LiamMcDermott34/Muon-Detector/V2_Dual_Gieger_Counter/Photos/IMG_7273.webp

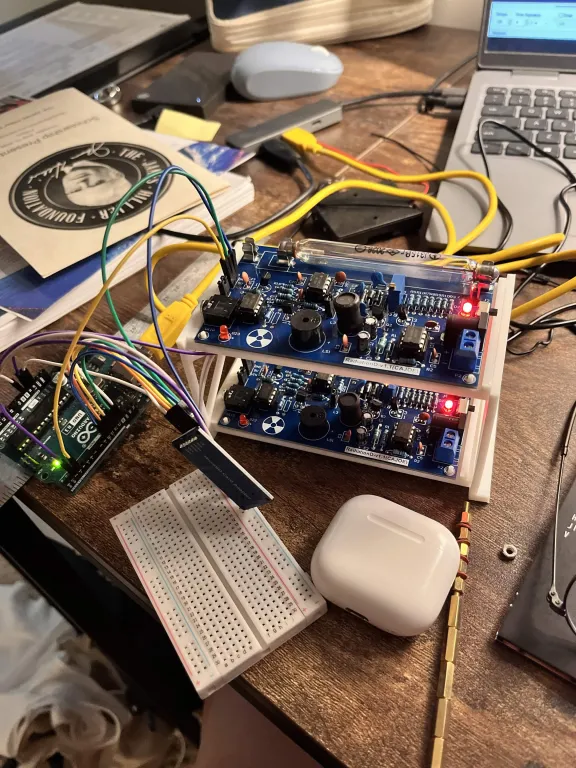
V2_Dual_Gieger_Counter/Photos/IMG_7273.webp
