LiamMcDermott34/Muon-Detector/V4_Moun_Data_Collector/Photos/IMG_7325.webp

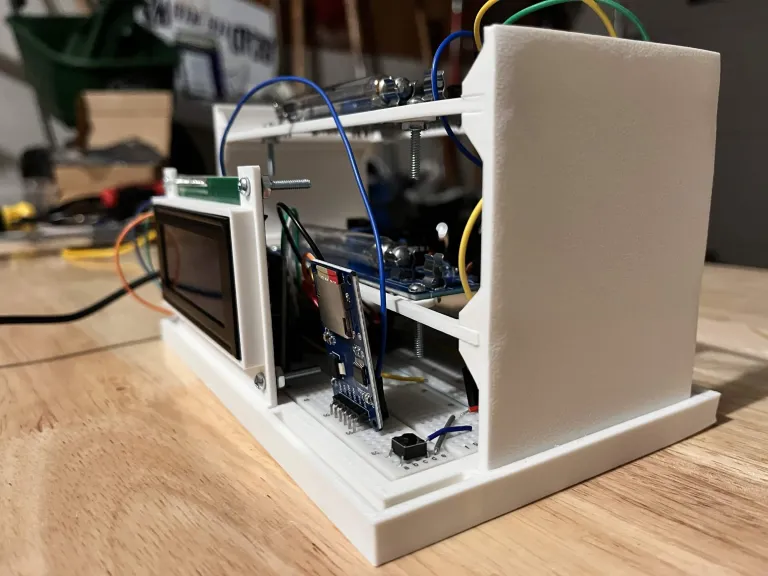
V4_Moun_Data_Collector/Photos/IMG_7325.webp
