LiamMcDermott34/Muon-Detector/V2_Dual_Gieger_Counter/Hardware/Fantastic Habbi-Jaban (5).3mf

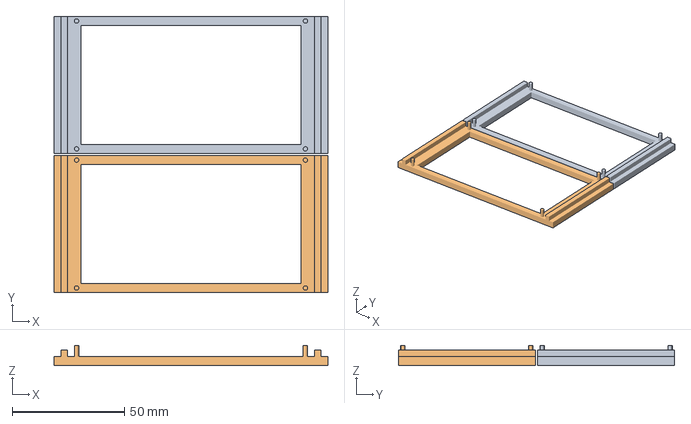
[picture p13: CAD file, 2026-07-22]
V2_Dual_Gieger_Counter/Hardware/Fantastic Habbi-Jaban (5).3mf
122.0 x 123.0 x 9.00 mm
Fantastic Habbi-Jaban (5).stl_A x 2
