LiamMcDermott34/Muon-Detector/V3_Moun_Density_Test/Hardware/Fantastic Habbi-Jaban (9).stl

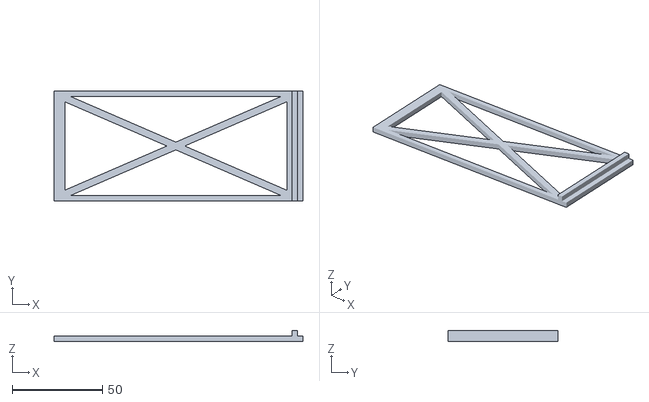
[picture p14: CAD file, 2026-07-22]
V3_Moun_Density_Test/Hardware/Fantastic Habbi-Jaban (9).stl
138.0 x 61.0 x 6.00
