LiamMcDermott34/Muon-Detector/V3_Moun_Density_Test/Hardware/Fantastic Habbi-Jaban (6).stl

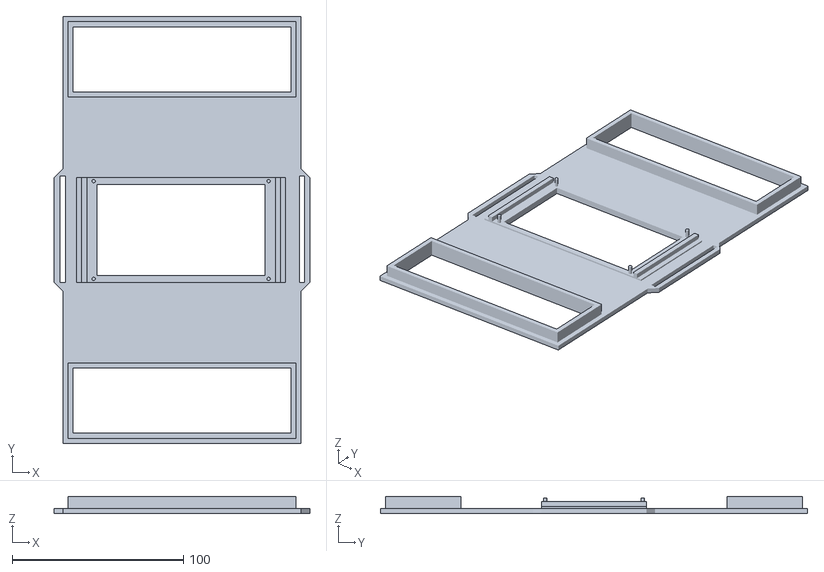
[picture p15: CAD file, 2026-07-22]
V3_Moun_Density_Test/Hardware/Fantastic Habbi-Jaban (6).stl
149.0 x 249.0 x 10.0
