LiamMcDermott34/Muon-Detector/V3_Moun_Density_Test/Hardware/Fantastic Habbi-Jaban (7).stl

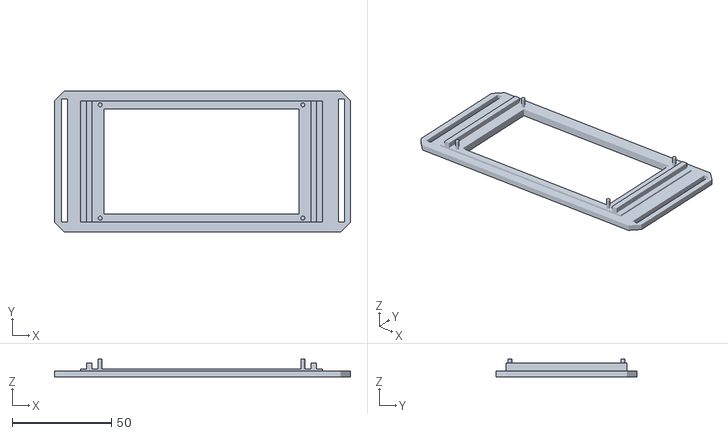
[picture p16: CAD file, 2026-07-22]
V3_Moun_Density_Test/Hardware/Fantastic Habbi-Jaban (7).stl
149.0 x 71.0 x 9.00
