LiamMcDermott34/Muon-Detector/(list of files, cad)

Other CAD files:
V2_Dual_Gieger_Counter/Hardware/Fantastic Habbi-Jaban (5).stl
