LiamMcDermott34/Muon-Detector/V3_Moun_Density_Test/DATA/DATA02.CSV

Time(ms) | D1_Counts | D2_Counts | Coincidences
60001 | 24 | 16 | 0
120001 | 45 | 36 | 0
180001 | 60 | 55 | 0
240001 | 81 | 74 | 0
300001 | 94 | 100 | 0
360001 | 112 | 123 | 0
420001 | 128 | 137 | 0
480001 | 147 | 161 | 0
540001 | 166 | 187 | 0
600001 | 183 | 206 | 0
660001 | 200 | 233 | 0
720001 | 221 | 261 | 0
780001 | 244 | 280 | 0
840001 | 267 | 301 | 0
900001 | 289 | 323 | 0
960001 | 310 | 348 | 1
1020001 | 325 | 366 | 1
1080001 | 346 | 383 | 2
1140001 | 357 | 406 | 2
1200001 | 376 | 420 | 2
1260001 | 393 | 432 | 2
1320001 | 417 | 448 | 2
1380001 | 438 | 470 | 2
1440001 | 460 | 484 | 2
1500001 | 476 | 505 | 2
1560001 | 494 | 528 | 2
1620001 | 513 | 550 | 2
1680001 | 536 | 575 | 3
1740001 | 542 | 590 | 3
1800001 | 562 | 615 | 3
1860001 | 573 | 639 | 3
1920001 | 593 | 652 | 3
1980001 | 610 | 676 | 3
2040001 | 629 | 692 | 3
2100001 | 651 | 709 | 3
2160001 | 670 | 738 | 3
2220001 | 690 | 757 | 3
2280001 | 710 | 782 | 3
2340001 | 727 | 803 | 3
2400001 | 743 | 815 | 3
2460001 | 764 | 841 | 4
2520001 | 783 | 865 | 4
2580001 | 805 | 890 | 4
2640001 | 821 | 912 | 4
2700001 | 844 | 930 | 4
2760001 | 862 | 943 | 4
2820001 | 887 | 950 | 4
2880001 | 903 | 973 | 5
2940001 | 915 | 986 | 6
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
