LiamMcDermott34/Muon-Detector/V3_Moun_Density_Test/DATA/DATA03.CSV

Time(ms) | D1_Counts | D2_Counts | Coincidences
60000 | 15 | 11 | 0
120000 | 27 | 31 | 0
180000 | 45 | 47 | 0
240000 | 58 | 63 | 0
300000 | 75 | 85 | 0
360000 | 97 | 104 | 0
420000 | 120 | 128 | 0
480000 | 134 | 146 | 0
540000 | 150 | 169 | 0
600000 | 165 | 184 | 0
660000 | 183 | 203 | 0
720000 | 196 | 220 | 0
780000 | 210 | 238 | 0
840000 | 220 | 256 | 0
900000 | 231 | 273 | 0
960000 | 243 | 291 | 0
1020000 | 255 | 312 | 0
1080000 | 270 | 328 | 0
1140000 | 291 | 347 | 0
1200000 | 304 | 359 | 0
1260000 | 321 | 380 | 0
1320000 | 334 | 398 | 0
1380000 | 350 | 413 | 0
1440000 | 371 | 437 | 0
1500000 | 382 | 463 | 0
1560000 | 394 | 487 | 0
1620000 | 411 | 501 | 0
1680000 | 422 | 521 | 0
1740000 | 439 | 542 | 0
1800000 | 456 | 558 | 0
1860000 | 471 | 572 | 0
1920000 | 490 | 587 | 1
1980000 | 505 | 599 | 1
2040000 | 518 | 613 | 1
2100000 | 537 | 627 | 1
2160000 | 544 | 647 | 1
2220000 | 561 | 668 | 1
2280000 | 571 | 686 | 1
2340000 | 582 | 699 | 1
2400000 | 601 | 718 | 1
2460000 | 618 | 736 | 1
2520000 | 631 | 753 | 1
2580000 | 645 | 778 | 1
2640000 | 670 | 792 | 1
2700000 | 688 | 810 | 1
2760000 | 708 | 825 | 1
2820000 | 716 | 848 | 1
2880000 | 727 | 859 | 1
2940000 | 741 | 883 | 1
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
