LiamMcDermott34/Muon-Detector/V3_Moun_Density_Test/Photos/IMG_7288.webp

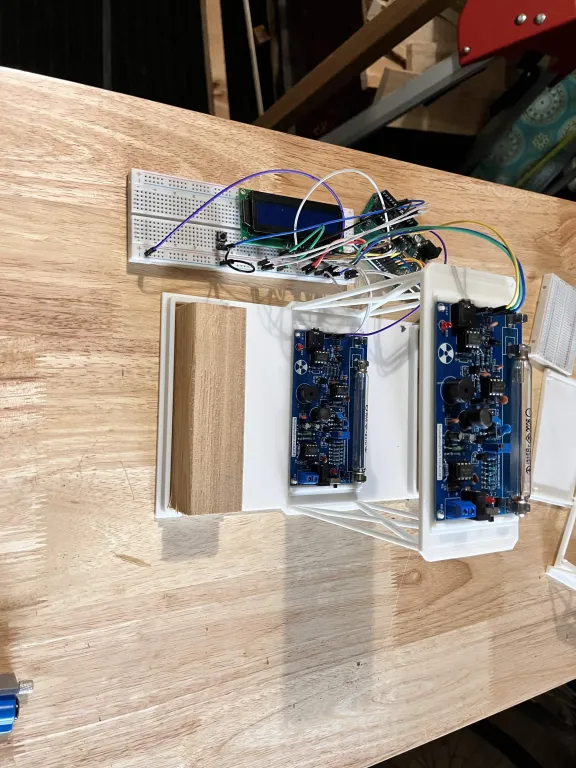
V3_Moun_Density_Test/Photos/IMG_7288.webp
