LiamMcDermott34/Muon-Detector/(commit log)

2026-07-22 Add Geiger Counter software for Arduino UNO
    Initial implementation of a Geiger Counter program for Arduino that counts radiation pulses and logs counts per minute.
2026-07-22 Add Test_DATA.CSV to V3_Moun_Density_Test
    [Test_DATA.CSV]
2026-07-22 Rename Test_DATA.CSV to match directory structure
    [Test_DATA.CSV]
2026-07-22 Update Devlog with project milestones and next steps
    Documented the successful assembly and testing phases of the dual Geiger counter system, including milestones achieved and future project directions.
2026-07-29 Add ESP32 muon detector script with features
    This commit adds a comprehensive script for an ESP32 muon detector, including functionalities for LCD display, Wi-Fi connectivity, NTP time synchronization, and data logging to a MicroSD card.
2026-08-02 Refactor muon detector code with new features
    Refactor muon detector code to improve structure and readability. Added RTC and LCD functionalities, updated interrupt handling, and optimized data logging.
